keonaarneson/ECE380-audio-amplifier/ECE380 Cost Model Spring 2026.xlsx

 |  |  | Cost Model Specifications
Equipment |  |  | Components | look up costs in units of thousands |  |  |  |  | Total Production Hours |  | 7862.4
 |  |  |  | Quantity | Bulk Quantity | Cost Per Part | Total Cost |  | Labor Hours |  | 8736
Board Router |  |  | FR4 Board | 1 | N/A | $0.25 | $0.25
Pick and Place |  |  | Amplifier | 1 | 1000 | $0.45 | $0.45
Test |  |  | Jacks | 2 | 10000 | $0.74 | $1.47
 |  |  | Audio Connector | 1 | 6000 | $0.84 | $0.84
 |  |  | Blocking Capacitor (Cb) | 1 | 25000 | $0.31 | $0.31
 |  |  | Shunt Capacitor (Csh) | 1 | 4000 | $0.01 | $0.01
 |  |  | Bypass Capacitor (Cbyp) | 1 | 20000 | $0.02 | $0.02
 |  |  | Decoupling Capacitor (Cd) | 1 | 6000 | $0.06 | $0.06
 |  |  | Variable Resistor (POT) | 1 | 5000 | $1.63 | $1.63
 |  |  | Shunt Resistor (Rsh) | 1 | 5000 | $0.00119 | $0.00119
 |  |  |  | Total |  |  | $5.04
Facility Depreciation (straight line) | 20 | years
Equipment Depreciation (straight line) | 5 | years
Factory Cost Base | $2700000 | plus | Factory Cost per sq ft for equipment placement | $3000
Equipment | Cost | Throughput (parts/hr) | Tech Support | Engineering Support | Operator Support | Yield | Space req (sq ft) | Total # of tools | Total Cost | Tool Depreciation | Tool Space Cost | Parts Per Hour | Parts Per Year | Technicians | Technicians (Whole Number) | Technician Cost | Operators | Operators (Whole Number) | Operator Cost | Engineers | Engineers (Whole Numbers) | Engineer Cost
Ult Board Router | $220000 | 66 | 0.20 | 0.10 | 0.20 | 89% | 90 | 50 | $11000000 | $2200000 | $13500000 | 3300 | 25945920 | 10 | 10 | $3494400 | 10 | 10 | $2184000 | 5 | 5 | $2500000
BH Board Router | $205000 | 71 | 0.10 | 0.15 | 0.20 | 91% | 85 | 0 | $0 | $0 | $0 | 0 | 0 | 0 | 0 | $0 | 0 | 0 | $0 | 0 | 0 | $0
Sl Board Router | $290000 | 83 | 0.15 | 0.10 | 0.15 | 90% | 95 | 0 | $0 | $0 | $0 | 0 | 0 | 0 | 0 | $0 | 0 | 0 | $0 | 0 | 0 | $0
 |  |  |  |  |  |  |  |  | $0 | $0 | $0 | 0 | 0 | 0 | 0 | $0 | 0 | 0 | $0 | 0 | 0 | $0
 |  |  |  |  |  |  |  |  | $0 | $0 | $0 | 0 | 0 | 0 | 0 | $0 | 0 | 0 | $0 | 0 | 0 | $0
Ult Pick and Place | $400000 | 33 | 0.20 | 0.15 | 0.20 | 96% | 100 | 100 | $40000000 | $8000000 | $30000000 | 3300 | 25945920 | 20 | 20 | $6988800 | 20 | 20 | $4368000 | 15 | 15 | $7500000
BH Pick and Place | $390000 | 37 | 0.25 | 0.10 | 0.25 | 94% | 120 | 0 | $0 | $0 | $0 | 0 | 0 | 0 | 0 | $0 | 0 | 0 | $0 | 0 | 0 | $0
SI Pick and Place | $460000 | 40 | 0.15 | 0.20 | 0.20 | 93% | 130 | 0 | $0 | $0 | $0 | 0 | 0 | 0 | 0 | $0 | 0 | 0 | $0 | 0 | 0 | $0
 |  |  |  |  |  |  |  |  | $0 | $0 | $0 | 0 | 0 | 0 | 0 | $0 | 0 | 0 | $0 | 0 | 0 | $0
 |  |  |  |  |  |  |  |  | $0 | $0 | $0 | 0 | 0 | 0 | 0 | $0 | 0 | 0 | $0 | 0 | 0 | $0
Ult Test | $375000 | 33 | 0.25 | 0.15 | 0.25 | 97% | 75 | 0 | $0 | $0 | $0 | 0 | 0 | 0 | 0 | $0 | 0 | 0 | $0 | 0 | 0 | $0
BH Test | $380000 | 35 | 0.15 | 0.10 | 0.25 | 95% | 85 | 0 | $0 | $0 | $0 | 0 | 0 | 0 | 0 | $0 | 0 | 0 | $0 | 0 | 0 | $0
SI Test | $445000 | 41 | 0.10 | 0.10 | 0.30 | 97% | 95 | 80 | $35600000 | $7120000 | $22800000 | 3280 | 25788672 | 8 | 8 | $2795520 | 24 | 24 | $5241600 | 8 | 8 | $4000000
 |  |  |  |  |  |  |  |  | $0 | $0 | $0 | 0 | 0 | 0 | 0 | $0 | 0 | 0 | $0 | 0 | 0 | $0
 |  |  |  |  |  |  |  | Total | $86600000 | $17320000 | $66300000 | 3280 | 25788672 | 38 | 38 | $13278720 | 54 | 54 | $11793600 | 28 | 28 | $14000000
Operator Costs | $25 | per hr
Technician Labor Costs | $40 | per hr
Engineering Intern Cost | $125000 | per year |  |  |  |  |  |  |  |  |  |  |  |  | Labor + Fringe | $17262336 |  | Labor + Fringe | $15331680 |  | Labor + Fringe | $18200000
Factory Overhead Base Cost | $2500000 | per year |  |  |  |  | Category | Cost | Cost/Part |  | Total Yield | 82.97%
 |  |  |  |  |  |  | Materials | $130004048.08 | $6.08 |  | Yielded Parts Per Year | 21397841
Fringe on Labor | 30% |  |  |  |  |  | Labor | $50794016 | $2.37
 |  |  |  |  |  |  | Equipment | $17320000 | $0.81
 |  |  |  |  |  |  | Facilities | $69000000 | $3.22
 |  |  |  |  |  |  | Overhead | $2500000 | $0.12
 |  |  |  |  |  |  | TOTAL | $269618064.08 | $12.60
