keonaarneson/ECE380-audio-amplifier/Audio Amplifier Performance Calculator.xlsx

Sheet: Overview
Test Procedure: Audio Amplifier Performance Calculator
This spreadsheet is to be used with the Audio Amplifier Testing Procedure pdf
Input raw data obtain from the test and record the outputted performance calculations
Test Guide
A | Maximum Power Output
B | Frequency Response
C | I/O Impedance
D | Efficiency

Sheet: A
Maximum Power Output
 |  |  |  |  |  |  |  | Legend
Measure the maximum power output, PMAX, |  |  |  |  |  |  |  |  | Input
for a total harmonic distortion (THD) below 1% using the first 5 harmonics. |  |  |  |  |  |  |  |  | Output
Total Harmonic Distortion Calculator
Harmonic (Hz) | VHARM (dBV) | Voltage (Vamp) | Voltage (Vrms) | THD (%) | VIMAX (V) | VOMAX (V) | Power (W)
1k |  | 1 | 0.7071067812 | 237.841423 |  |  | 0
2k |  | 1 | 0.7071067812
3k |  | 1 | 0.7071067812
4k |  | 1 | 0.7071067812
5k |  | 1 | 0.7071067812

Sheet: B
Frequency Response
 |  |  |  |  |  | Legend
Calculates gain with Vin and Vout |  |  |  |  |  |  | Input
Plots frequency response with calculated gain and inputted phase |  |  |  |  |  |  | Output
Gain and Phase Plotter
Frequency (Hz) | VIN (V) | VOUT (V) | Gain (V/V) | Gain (dB) | Phase (°)
20 |  |  | #DIV/0! | #DIV/0!
40 |  |  | #DIV/0! | #DIV/0!
80 |  |  | #DIV/0! | #DIV/0!
160 |  |  | #DIV/0! | #DIV/0!
320 |  |  | #DIV/0! | #DIV/0!
640 |  |  | #DIV/0! | #DIV/0!
1280 |  |  | #DIV/0! | #DIV/0!
2560 |  |  | #DIV/0! | #DIV/0!
5120 |  |  | #DIV/0! | #DIV/0!
10240 |  |  | #DIV/0! | #DIV/0!
20000 |  |  | #DIV/0! | #DIV/0!

Sheet: C
Input and Output Impedance
 |  |  |  |  |  |  | Legend
Calculates the input impedance with Vin and Iin with a constant load |  |  |  |  |  |  |  | Input
Calculates the output impedance using values of different load values |  |  |  |  |  |  |  | Output
Input and Output Impedance Calculator
RL (Ω) | VIN (V) | IIN (A) | RIN (Ω) | VOUT (V) | IOUT (A) | ROUT (Ω)
4 |  |  | #DIV/0! |  |  | #DIV/0!
16

Sheet: D
Efficiency
 |  |  |  |  |  |  |  | Legend
Calculates the total power usage and power out |  |  |  |  |  |  |  |  | Input
Calculates power efficiency to the load |  |  |  |  |  |  |  |  | Output
Power Efficiency Calculator
VIN (V) | VSS (V) | ISS (A) | PSS (W) | VOUT (V) | IOUT (A) | POUT (W) | Eff. (%)
VIMAX |  |  | 0 |  |  | 0 | #DIV/0!
0.5*VIMAX |  |  | 0 |  |  | 0 | #DIV/0!
