keonaarneson/ECE380-audio-amplifier/(commit log)

2026-03-28 Added background and simulation files
    [Audio Amplifier Analysis.xlsx]
2026-04-04 Zipped files and added KiCad
2026-04-12 Testing files
    [Audio Amplifier Performance Calculator.xlsx]
